eldar6776/WindSwitch/doc/tabela vjetra.pdf

DIP
vrijednost
Frekvencija (Hz) Brzina vjetra (m/s) | Opis snage vjetra | Period (ms)
0 | 0.0 Hz | 0.0 m/s | Nema vjetra | ∞ (pauza)
1 | 1.0 Hz | 0.4 m/s | Slabi povjetarac | 1000
2 | 2.0 Hz | 0.8 m/s | Lagani vjetar | 500
3 | 4.0 Hz | 1.6 m/s | Pomjera lišće | 250
4 | 6.5 Hz | 2.6 m/s | Počinje nositi prašinu | 154
5 | 10 Hz | 4.0 m/s | Lagani povjetarac | 100
6 | 15 Hz | 6.0 m/s | Počinje biti neugodno | 67
7 | 20 Hz | 8.0 m/s | Jak vjetar | 50
8 | 25 Hz | 10.0 m/s | Obara veš sa štrikova | 40
9 | 30 Hz | 12.0 m/s | Ljuljaju se krošnje | 33
10 | 35 Hz | 14.0 m/s | Hodanje postaje teško | 29
11 | 40 Hz | 16.0 m/s | Počinje obarati grane | 25
12 | 45 Hz | 18.0 m/s | Nositi šešir postaje nemoguće | 22
13 | 50 Hz | 20.0 m/s | Vrlo jak vjetar | 20
14 | 60 Hz | 24.0 m/s | Snažan vjetar, ruši manje stvari | 17
15 | 75 Hz | 30.0 m/s | Čupa grane | 13
16 | 90 Hz | 36.0 m/s | Ruši manje konstrukcije | 11
17–63 | 100 Hz | 40.0 m/s | Skida krovove, ozbiljna šteta | 10
