eldar6776/WindSwitch/hw/DE-230724/DE-230724.pdf

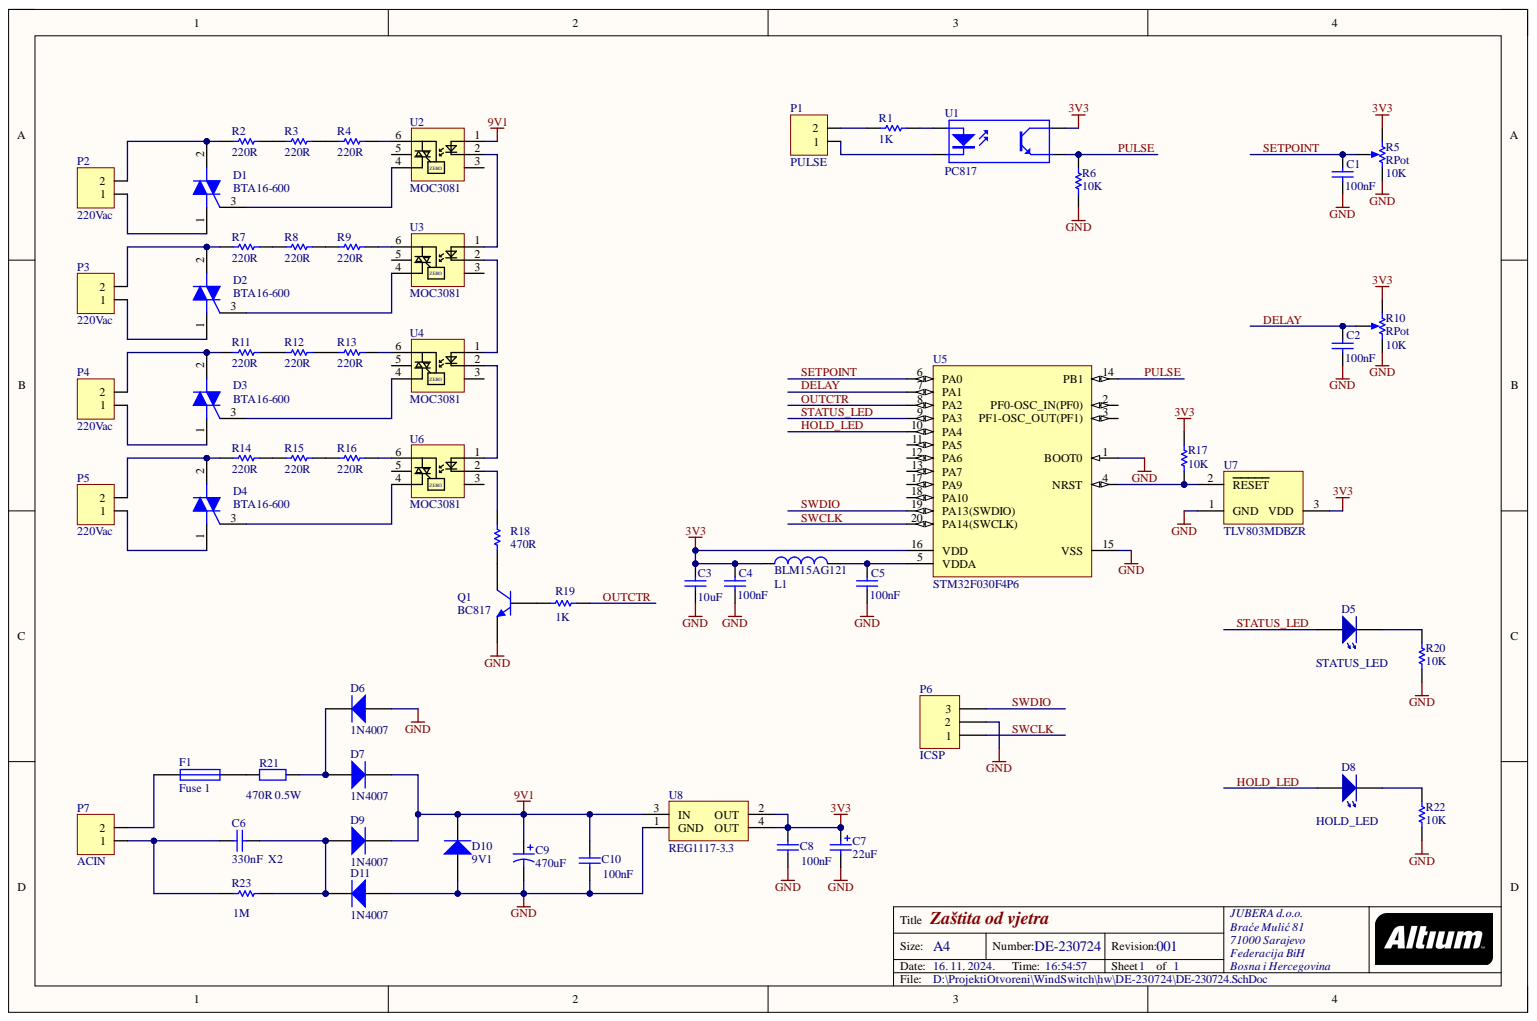
[picture p2: page 1]

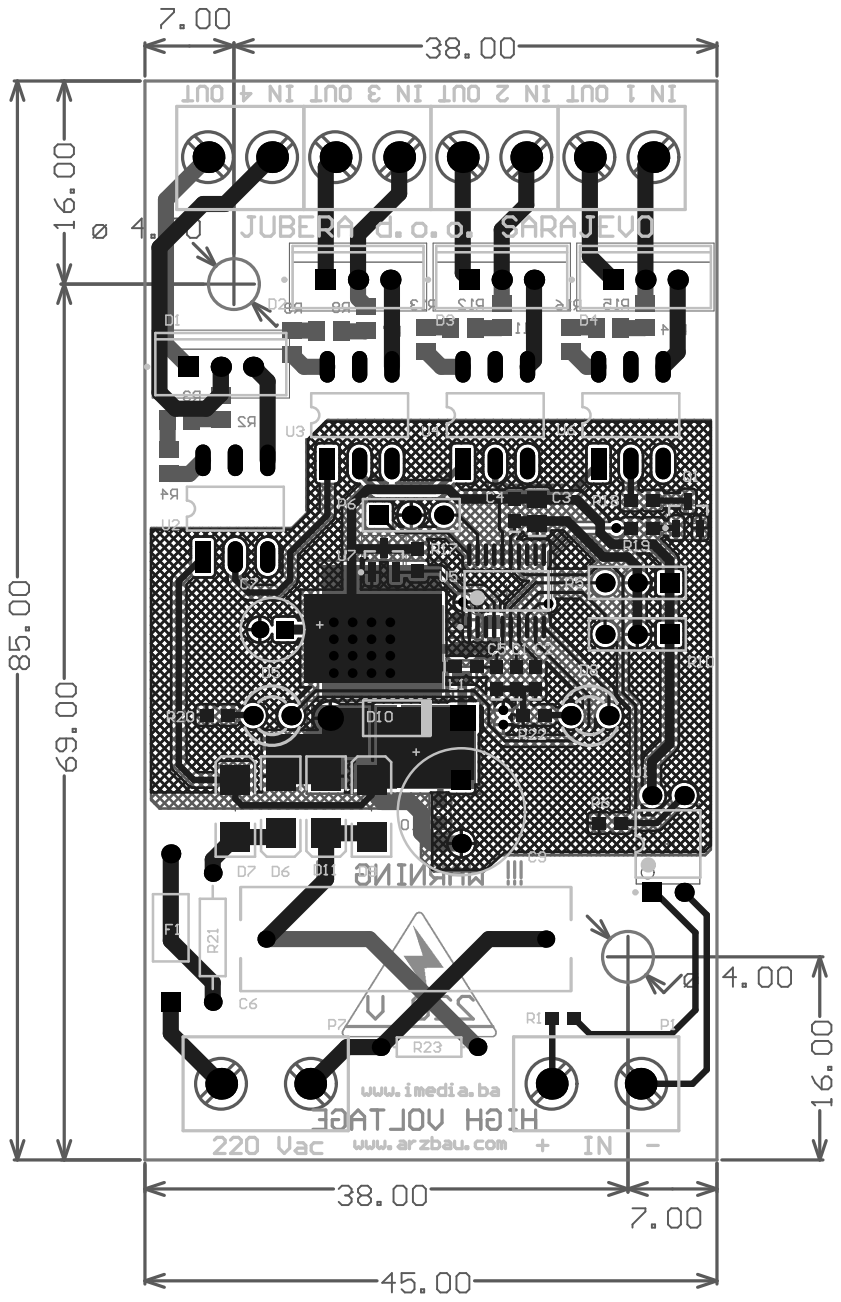
[picture p3: page 2]

Bill of Materials | Bill of Materials for Project [DE-230724.PrjPcb] (No PCB Document Selected)
Source Data From: | DE-230724.PrjPcb
Project: | | DE-230724.PrjPcb
Variant: | | None
Creation Date: 16. 11. 2024. | 16:55
Print Date: | 45612 | 45612,70529
Footprint | Comment | LibRef | Designator | Description | Quantity
603 | C0603 | C0603 | C1, C2, C4, C5, C8, C10 | Ceramic Chip Capacitor - 25V, Ceramic Chip | 6
805 | C0805 | C0805 | C3 | Ceramic Chip Capacitor - 25V | 1
0,33uF X2 | 330nF X2 | 0,33uF X2 | C6 | Dipped Radial Multilayer Ceramic Capacitor | 1
CAPPR2-5X1122uF | EKA00AA247F00C7 | Aluminum Electrolytic Capacitor, Radial Sty | 1
CAPPR5-10X1470uF | EKA00DC347E00C9 | Aluminum Electrolytic Capacitor, Radial Sty | 1
ONSC-TO-220BTA16-600 | BTA08-600BW3GD1, D2, D3, D4 | Triacs, Silicon Bidirectional Thyristor, 3-Pin | 4
LED 3mm | STATUS_LED | LED 3mm | D5 | 1
SMB | 1N4007 | Diode 1N4007 | D6, D7, D9, D11 | 1 Amp General Purpose Rectifier | 4
LED 3mm | HOLD_LED | LED 3mm | D8 | 1
DO-41 | 9V1 | Diode 1N914 | D10 | High Conductance Fast Diode | 1
PIN-W2/E2.8 | Fuse 1 | Fuse 1 | F1 | Fuse | 1
603 | BLM15AG121 | Inductor_SMD | L1 | Inductor | 1
TERMINAL BLPULSE | TERMINAL BLOKP1 | Terminal blok konektor 3,5 mm | 1
TERMINAL BL220Vac | TERMINAL BLOKP2, P3, P4, P5 | Terminal blok konektor 3,5 mm | 4
HDR1X3 | ICSP | Header 3 | P6 | Header, 3-Pin | 1
TERMINAL BLACIN | TERMINAL BLOKP7 | Terminal blok konektor 3,5 mm | 1
SOT23_N | BC817 | BC817 | Q1 | NPN General-purpose Transistor | 1
ERA-0603 | 1K | ERAV | R1, R19 | Metal Film Thermosensitive Chip Resistor, 0 | 2
ERA-0805 | 220R | ERAS | R2, R3, R4, R7, R8, R9, R11, R12, R13,
Metal Film Thermosensitive Chip Resistor, 0 | 12
HDR1X3 | RPot | RPot | R5, R10 | Potentiometer | 2
ERA-0603 | 10K | ERAV | R6, R17, R20, R22 | Metal Film Thermosensitive Chip Resistor, 0 | 4
ERA-0603 | 470R | ERAV | R18 | Metal Film Thermosensitive Chip Resistor, 0 | 1
AXIAL-0.4 | Res2 | Res2 | R21 | Resistor | 1
AXIAL-0.3 | Res1 | Res1 | R23 | Resistor | 1
DIP-4 | PC817 | PC817 | U1 | 4-Pin Phototransistor Optocoupler | 1
DIP6 | MOC3081 | MOC3081 | U2, U3, U4, U6 | Zero-Cross Optoisolator Triac Driver | 4
STM-TSSOP2STM32F030F4P6STM32F030F4P6U5 | ARM Cortex-M0 32-bit MCU, 16 KB Flash, 4 | 1
DBZ3_N | TLV803MDBZR | TLV803MDBZR | U7 | Voltage Supervisor with Active-Low, Open D | 1
ZZ311 | REG1117-3.3 | REG1117-3.3 | U8 | 800mA and 1A Low Dropout Positive Regula | 1

62
Approved | Notes
