eldar6776/WindSwitch/doc/impulsgeber.pdf

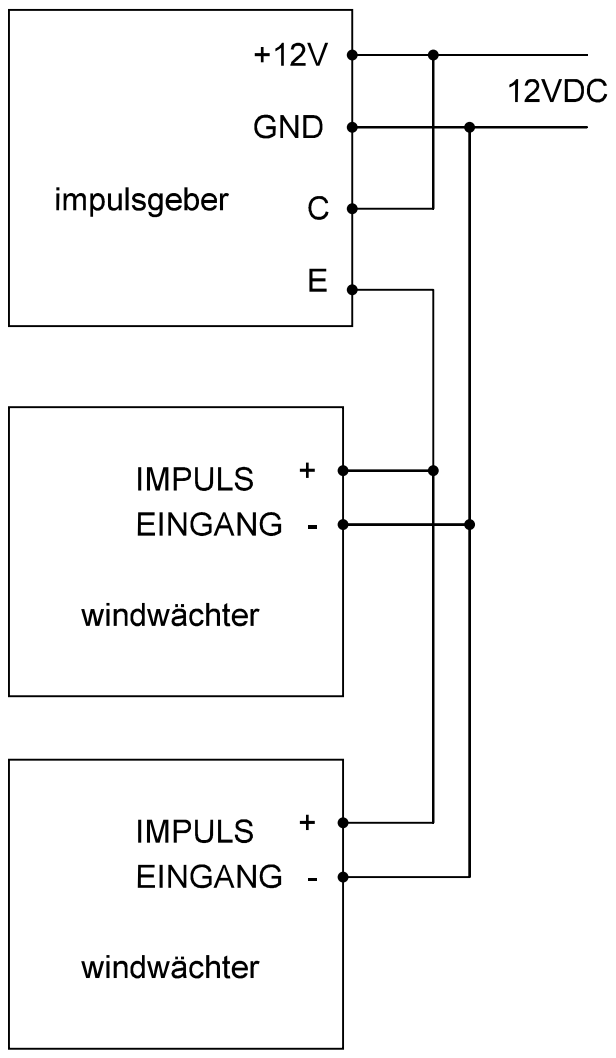
[picture p4: page 1]
