eldar6776/WindSwitch/doc/WindSwitch.pdf

BRZINA | VRIJEME
VJETRA | ODGODE

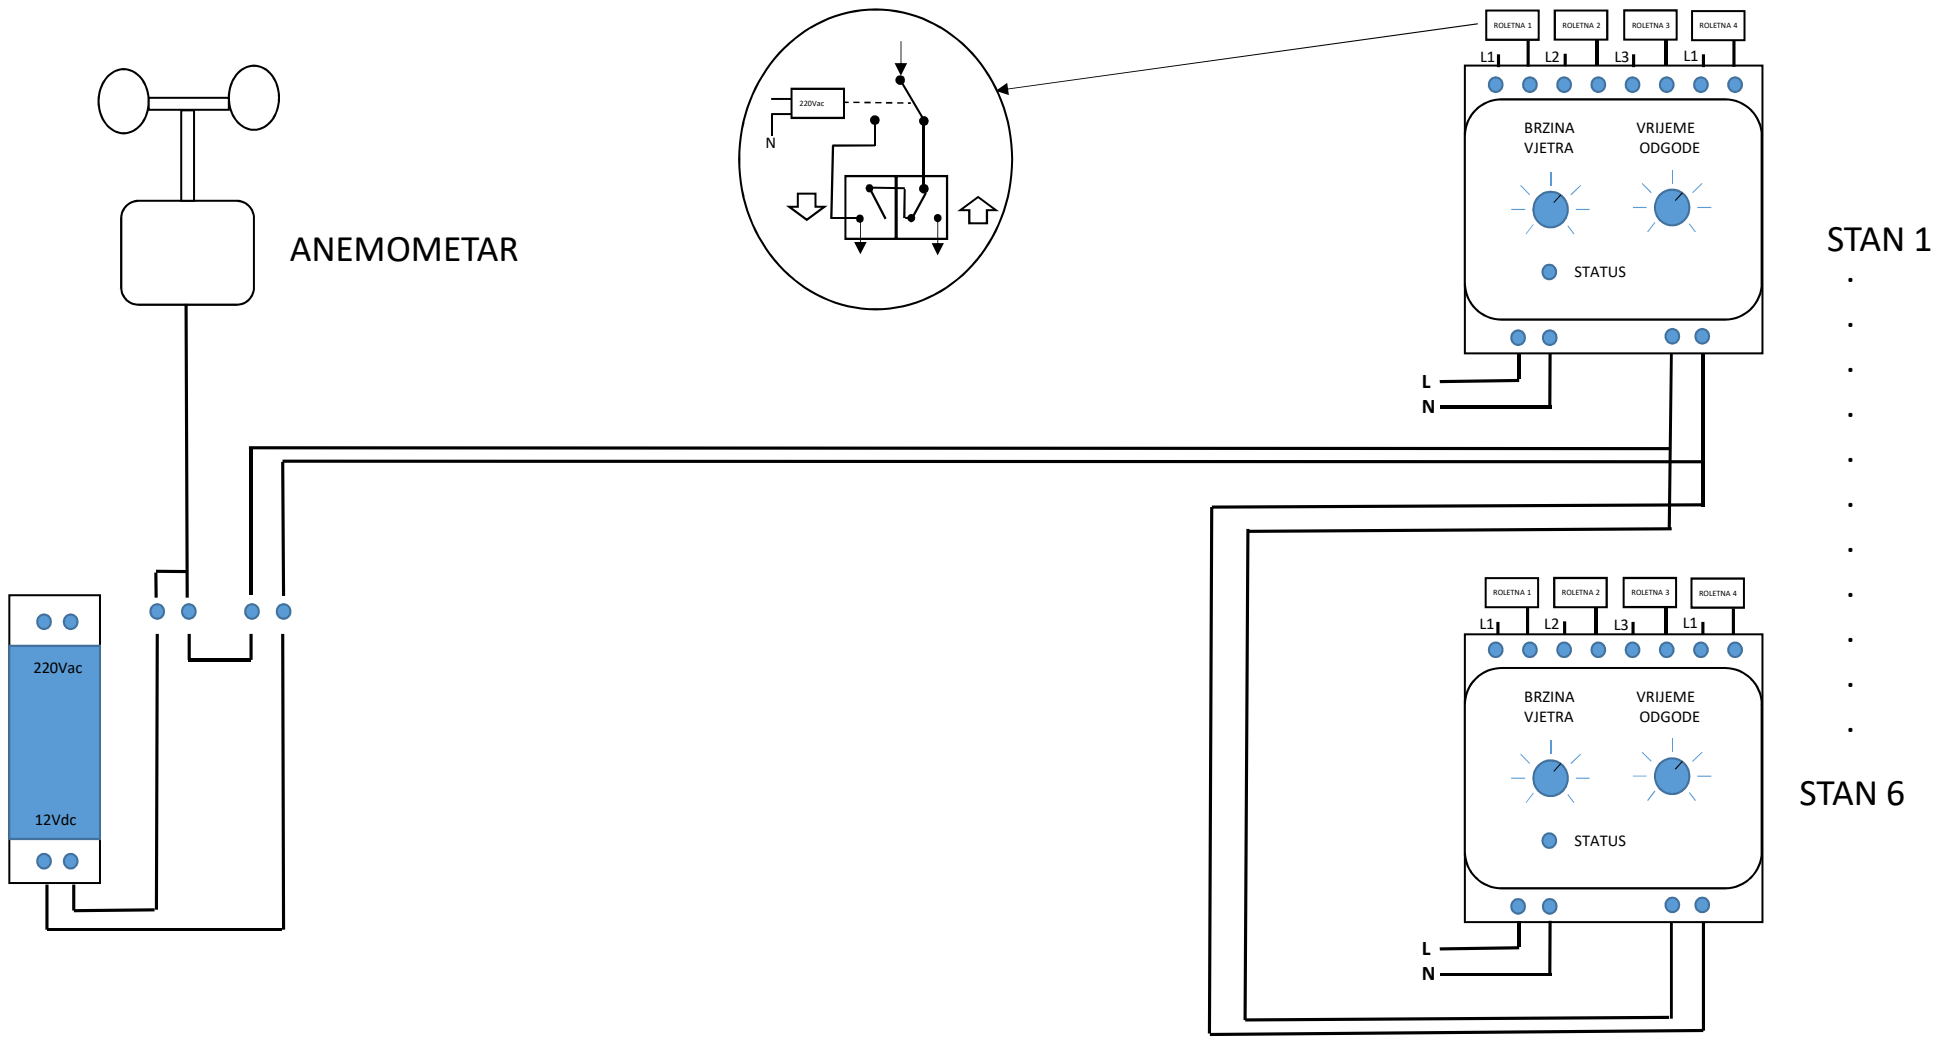
[picture p5: page 1]
BRZINA; VRIJEME; VJETRA; ODGODE; STATUS; 220Vac; 12Vdc; STAN 6; ANEMOMETAR; STAN 1; 220Vac N; ROLETNA 1; ROLETNA 2; ROLETNA 3; ROLETNA 4 L1
