eldar6776/WindSwitch/(list of files, drawings)

Other design files:
hw/DE-230724/DE-230724.PcbDoc
hw/DE-230724/DE-230724.PcbLib
hw/DE-230724/DE-230724.PrjPcb
hw/DE-230724/DE-230724.SchDoc
hw/DE-230724/DE-230724.SchLib
