eldar6776/WindSwitch/fw/DE-070924/Core/Src/main.c

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
/* Includes ------------------------------------------------------------------*/
#include "main.h"

ADC_HandleTypeDef hadc;

IWDG_HandleTypeDef hiwdg;

TIM_HandleTypeDef htim3;

/* USER CODE BEGIN PV */
#define IDLE   0
#define DONE   1
#define F_CLK  8000000UL
#define ADC_READOUT_PERIOD 100
#define TRIGGER_TIME 5000 //  wind treshold to trigger shutter down

volatile uint8_t gu8_State = IDLE, tick = 0, tickcnt = 0, redled = 0, init = 0;
volatile uint8_t gu8_MSG[35] = {'\0'};
volatile uint32_t gu32_T1 = 0;
volatile uint32_t gu32_T2 = 0;
volatile uint32_t gu32_Ticks = 0;
volatile uint16_t gu16_TIM3_OVC = 0;
volatile uint32_t gu32_Freq = 0;
volatile uint32_t ledtmr, ledtime = 200, nulltmr = 0, trgtmr = 0;
volatile uint32_t redledtmr = 0;
volatile uint8_t setpoint = 0, delay = 0;
/* USER CODE END PV */

void SystemClock_Config(void);
static void MX_GPIO_Init(void);
static void MX_ADC_Init(void);
static void MX_IWDG_Init(void);
static void MX_TIM3_Init(void);
/* USER CODE BEGIN PFP */
static void LED(void);
static void OUT(void);
static void ADC3_Read(void);
long map(long x, long in_min, long in_max, long out_min, long out_max);
/* USER CODE END PFP */

/**
  * @brief  The application entry point.
  * @retval int
  */
int main(void)
{

	/* MCU Configuration--------------------------------------------------------*/

	/* Reset of all peripherals, Initializes the Flash interface and the Systick. */
	HAL_Init();

	/* Configure the system clock */
	SystemClock_Config();

	/* Initialize all configured peripherals */
	MX_GPIO_Init();
	MX_ADC_Init();
	MX_IWDG_Init();
	MX_TIM3_Init();

	/* USER CODE BEGIN 2 */
	HAL_TIM_Base_Start_IT(&htim3);
	HAL_TIM_IC_Start_IT(&htim3, TIM_CHANNEL_4);

	/* USER CODE END 2 */

	/* Infinite loop */
	/* USER CODE BEGIN WHILE */
	while(1)
	{
		ADC3_Read();
		LED();
		OUT();
		/* USER CODE END WHILE */

		/* USER CODE BEGIN 3 */
		if(nulltmr && (HAL_GetTick() - nulltmr >= 2000))
		{
			gu32_Freq = 0;
			nulltmr = 0;
		}

#ifdef USE_WATCHDOG
		HAL_IWDG_Refresh(&hiwdg);
#endif
	}
	/* USER CODE END 3 */
}

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
/* USER CODE BEGIN 4 */
long map(long x, long in_min, long in_max, long out_min, long out_max)
{
	return (x - in_min) * (out_max - out_min) / (in_max - in_min) + out_min;
}

void HAL_TIM_IC_CaptureCallback(TIM_HandleTypeDef* htim)
{
	if(gu8_State == IDLE)
	{
		gu32_T1 = TIM3->CCR4;
		gu16_TIM3_OVC = 0;
		gu8_State = DONE;
	}
	else if(gu8_State == DONE)
	{
		gu32_T2 = TIM3->CCR4;
		gu32_Ticks = (gu32_T2 + (gu16_TIM3_OVC * 65536)) - gu32_T1;
		gu32_Freq = (uint32_t)(F_CLK / gu32_Ticks) + 1;
		gu8_State = IDLE;
		tick = 1;
	}
	nulltmr = HAL_GetTick();
}

void HAL_TIM_PeriodElapsedCallback(TIM_HandleTypeDef* htim)
{
	gu16_TIM3_OVC++;
}

static void OUT(void)
{
	if(!init) return;

	switch(redled)
	{
		case 0:
			if(setpoint < gu32_Freq)
			{
				trgtmr = HAL_GetTick();
				++redled;
			}
			break;
		case 1:
			if(setpoint >= gu32_Freq)
			{
				redled = 0;
			}
			else if((HAL_GetTick() - trgtmr) >= TRIGGER_TIME)
			{
				HAL_GPIO_WritePin(OUTCTRL_GPIO_Port, OUTCTRL_Pin, GPIO_PIN_SET);
				trgtmr = HAL_GetTick();
				++redled;
			}
			break;
		case 2:
			if(setpoint < gu32_Freq)
			{
				trgtmr = HAL_GetTick();
			}
			else if((HAL_GetTick() - trgtmr) >= (delay * 60000U))
			{
				HAL_GPIO_WritePin(OUTCTRL_GPIO_Port, OUTCTRL_Pin, GPIO_PIN_RESET);
				trgtmr = 0;
				redled = 0;
				redledtmr = 0;
			}
			break;
		default:
			trgtmr = 0;
			redled = 0;
			redledtmr = 0;
			break;

	}
}

static void LED(void)
{
	if(tick)
	{
		if(tickcnt == 0)
		{
			HAL_GPIO_WritePin(STATUS_LED_GPIO_Port, STATUS_LED_Pin, GPIO_PIN_SET);
			ledtmr = HAL_GetTick();
			++tickcnt;
		}
		else if(tickcnt == 1)
		{
			if((HAL_GetTick() - ledtmr) >= 5)
			{
				tick = 0;
				tickcnt = 0;
				ledtmr = HAL_GetTick();
				HAL_GPIO_WritePin(STATUS_LED_GPIO_Port, STATUS_LED_Pin, GPIO_PIN_RESET);
			}
		}
	}
	else if((HAL_GetTick() - ledtmr) >= ledtime)
	{
		ledtmr = HAL_GetTick();
		if(HAL_GPIO_ReadPin(STATUS_LED_GPIO_Port, STATUS_LED_Pin) == GPIO_PIN_SET)
		{
			HAL_GPIO_WritePin(STATUS_LED_GPIO_Port, STATUS_LED_Pin, GPIO_PIN_RESET);
			ledtime = 5000;
		}
		else
		{
			HAL_GPIO_WritePin(STATUS_LED_GPIO_Port, STATUS_LED_Pin, GPIO_PIN_SET);
			ledtime = 5;
		}
	}

	if(redled == 0)
	{
		HAL_GPIO_WritePin(HOLD_LED_GPIO_Port, HOLD_LED_Pin, GPIO_PIN_RESET);
	}
	else if(redled == 1)
	{
		if((HAL_GetTick() - redledtmr) >= 100)
		{
			redledtmr = HAL_GetTick();
			HAL_GPIO_TogglePin(HOLD_LED_GPIO_Port, HOLD_LED_Pin);
		}
	}
	else if(redled == 2) HAL_GPIO_WritePin(HOLD_LED_GPIO_Port, HOLD_LED_Pin, GPIO_PIN_SET);

}
/**
  * @brief
  * @param
  * @retval
  */
static void ADC3_Read(void)
{
	ADC_ChannelConfTypeDef sConfig;

	static uint32_t adc_timer = 0U;
	static uint32_t setpoint_sample_cnt = 0U;
	static uint32_t delay_sample_cnt = 0U;
	static uint16_t setpoint_sample[10] = {0U, 0U, 0U, 0U, 0U, 0U, 0U, 0U, 0U, 0U};
	static uint16_t delay_sample[10] = {0U, 0U, 0U, 0U, 0U, 0U, 0U, 0U, 0U, 0U};
	static uint8_t adc_cnt = 0U;
	uint32_t tmp_val = 0, t = 0;


	if((HAL_GetTick() - adc_timer) >= ADC_READOUT_PERIOD)
	{
		adc_timer = HAL_GetTick();
		sConfig.Rank = ADC_RANK_CHANNEL_NUMBER;
		sConfig.SamplingTime = ADC_SAMPLETIME_13CYCLES_5;
		if(adc_cnt == 0U) sConfig.Channel = ADC_CHANNEL_0;
		else if(adc_cnt == 1U) sConfig.Channel = ADC_CHANNEL_1;
		HAL_ADC_ConfigChannel(&hadc, &sConfig);
		HAL_ADC_Start(&hadc);
		HAL_ADC_PollForConversion(&hadc, 10);

		if(adc_cnt == 0U)
		{
			setpoint_sample[setpoint_sample_cnt] = HAL_ADC_GetValue(&hadc);
			if(++setpoint_sample_cnt >  9U) setpoint_sample_cnt = 0U;
			tmp_val = 0U;
			for(t = 0U; t < 10U; t++) tmp_val += setpoint_sample[t];
			tmp_val = tmp_val / 10U;
			setpoint = map(tmp_val, 0, 4095, 0, 100);
			++adc_cnt;
		}
		else if(adc_cnt == 1U)
		{
			delay_sample[delay_sample_cnt] = HAL_ADC_GetValue(&hadc);
			if(++delay_sample_cnt >  9U)
			{
				delay_sample_cnt = 0U;
				init = 1;
			}
			tmp_val = 0U;
			for(t = 0U; t < 10U; t++) tmp_val += delay_sample[t];
			tmp_val = tmp_val / 10U;
			delay = map(tmp_val, 0, 4095, 0, 50);
			adc_cnt = 0;
		}
	}
}
/* USER CODE END 4 */
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
