eldar6776/WindSwitch/fw/ImpulsGeber/Core/Inc/main.h

#define LED_RED_Pin GPIO_PIN_0
#define LED_RED_GPIO_Port GPIOB
#define LED_GREEN_Pin GPIO_PIN_1
#define LED_GREEN_GPIO_Port GPIOB
#define BUZZER_Pin GPIO_PIN_2
#define BUZZER_GPIO_Port GPIOB
#define ADDRESS_1_Pin GPIO_PIN_10
#define ADDRESS_1_GPIO_Port GPIOB
#define ADDRESS_2_Pin GPIO_PIN_11
#define ADDRESS_2_GPIO_Port GPIOB
#define ADDRESS_4_Pin GPIO_PIN_12
#define ADDRESS_4_GPIO_Port GPIOB
#define ADDRESS_8_Pin GPIO_PIN_13
#define ADDRESS_8_GPIO_Port GPIOB
#define ADDRESS_16_Pin GPIO_PIN_14
#define ADDRESS_16_GPIO_Port GPIOB
#define ADDRESS_32_Pin GPIO_PIN_15
#define ADDRESS_32_GPIO_Port GPIOB
#define DOOR_LOCK_Pin GPIO_PIN_3
#define DOOR_LOCK_GPIO_Port GPIOB
#define LED_STATUS_Pin GPIO_PIN_4
#define LED_STATUS_GPIO_Port GPIOB
#define WR_ENABLE_Pin GPIO_PIN_5
#define WR_ENABLE_GPIO_Port GPIOB
#define GET_SYS_FLAG        0xA0 // traži flagove sistema
#define GET_CARD_CNT        0xA1 // broj kartica u eepromu
#define GET_CARD_PRESENT    0xA2 // traži karticu u eepromu
#define GET_EVENT_CNT       0xA3 // broj događaja u eepromu
#define GET_EVENT_LAST      0xA4 // traži zadnji događaj iz eeproma
#define SET_SYS_TIME        0xB0 // podesi vrijeme sa param
#define SET_SYS_RESTART     0xB1 // softwerski restart applikacije
#define SET_CARD_ONE        0xB2 // dodaj novu karticu u eeprom
#define SET_DOOR_OPEN       0xB3 // aktiviraj bravu
#define SET_DOOR_TIME       0xB4 // podesi vrijeme brave
#define SET_DOOR_ENABLE     0xB5 // omogući kontrolu brave
#define SET_DOOR_DISABLE    0xB6 // onemogući kontrolu brave
#define SET_BUZZER_ENABLE   0xB7 // omogući buzzer
#define SET_BUZZER_DISABLE  0xB8 // onemogući buzzer
#define DELETE_CARD_ONE     0xC0 // obrisi karticu iz eeproma
#define DELETE_CARD_ALL     0xC1 // obrisi sve kartice iz eeproma
#define DELETE_EVENT_LAST   0xC2 // obrisi događaj prema datom indexu iz eeproma
#define DELETE_EVENT_ALL    0xC3 // obrisi sve događaje iz eeproma
