eldar6776/WindSwitch/fw/ImpulsGeber/Core/Src/main.c

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
/* Includes ------------------------------------------------------------------*/
#include "main.h"

/* USER CODE BEGIN Includes */
#include <stdlib.h>
/* USER CODE END Includes */

/* USER CODE BEGIN PTD */
typedef enum
{
    BUZZ_OFF = 0,
    BUZZ_CARD_VALID,
    BUZZ_CARD_INVALID,
    BUZZ_ERROR
} buzz_tdf;

typedef enum
{
    LED_OFF = 0,
    LED_CARD_VALID,
    LED_CARD_INVALID,
    LED_CARD_BLOCKED,
    LED_ERROR
} led_tdf;

typedef enum
{
    SYS_OK = 0,
    SYS_TXRX,
    SYS_ERR
} status_tdf;

typedef enum
{
    CLOSED = 0,
    OPEN
} doorlock_tdf;

doorlock_tdf door = CLOSED;
status_tdf state = SYS_OK;
led_tdf led = LED_OFF;
buzz_tdf buzz = BUZZ_OFF;
const uint16_t max_card_number = 250;
/* USER CODE END PTD */

I2C_HandleTypeDef hi2c1;

IWDG_HandleTypeDef hiwdg;

RTC_HandleTypeDef hrtc;
CRC_HandleTypeDef hcrc;
UART_HandleTypeDef huart1;
UART_HandleTypeDef huart2;

/* USER CODE BEGIN PV */


uint32_t previousTick = 0;
uint32_t pulseDelay = 100; // Početna vrednost (ms), biće postavljena prema DIP switch-u
const uint32_t dip_to_period[64] = {
    0, 500, 250, 125, 77, 50, 33, 25, 20, 16, 14, 12, 11, 10, 8, 7, 
    6, 5, 5, 5, 5, 5, 5, 5, 5, 5, 5, 5, 5, 5, 5, 5,  
    5, 5, 5, 5, 5, 5, 5, 5, 5, 5, 5, 5, 5, 5, 5, 5,  
    5, 5, 5, 5, 5, 5, 5, 5, 5, 5, 5, 5, 5, 5, 5, 5  
};


/* USER CODE END PV */

void SystemClock_Config(void);
static void MX_GPIO_Init(void);
/* USER CODE BEGIN PFP */
static uint32_t ReadDIP(void);

/* USER CODE END PFP */

/**
  * @brief  The application entry point.
  * @retval int
  */
int main(void)
{
    /* MCU Configuration--------------------------------------------------------*/

    /* Reset of all peripherals, Initializes the Flash interface and the Systick. */
    HAL_Init();

    /* Configure the system clock */
    SystemClock_Config();

    /* Initialize all configured peripherals */
    MX_GPIO_Init();

    /* Infinite loop */
    /* USER CODE BEGIN WHILE */
    while(1)
    {
        // Povremeno ažuriraj vrednost iz DIP switch-a
        static uint32_t lastDipRead = 0;
        if (HAL_GetTick() - lastDipRead >= 500) {  // Čitaj DIP na svakih 500ms
            lastDipRead = HAL_GetTick();
            pulseDelay = ReadDIP();
        }
        if (pulseDelay && (HAL_GetTick() - previousTick >= pulseDelay)) {
            previousTick = HAL_GetTick(); // Ažuriraj referentni trenutak
            HAL_GPIO_TogglePin(DOOR_LOCK_GPIO_Port, DOOR_LOCK_Pin); // Toggle impulsa
            HAL_GPIO_TogglePin(LED_STATUS_GPIO_Port, LED_STATUS_Pin); // Toggle impulsa
        }
        /* USER CODE END WHILE */

        /* USER CODE BEGIN 3 */
    }
    /* USER CODE END 3 */
}

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
/* USER CODE BEGIN 4 */
/**
  * @brief  init app
  * @param  none
  * @retval none
  */
static uint32_t ReadDIP(void)
{
    uint8_t rsadd = 0;
    if(HAL_GPIO_ReadPin(ADDRESS_1_GPIO_Port, ADDRESS_1_Pin) == GPIO_PIN_RESET) rsadd |= 0x01U;
    if(HAL_GPIO_ReadPin(ADDRESS_2_GPIO_Port, ADDRESS_2_Pin) == GPIO_PIN_RESET) rsadd |= 0x02U;
    if(HAL_GPIO_ReadPin(ADDRESS_4_GPIO_Port, ADDRESS_4_Pin) == GPIO_PIN_RESET) rsadd |= 0x04U;
    if(HAL_GPIO_ReadPin(ADDRESS_8_GPIO_Port, ADDRESS_8_Pin) == GPIO_PIN_RESET) rsadd |= 0x08U;
    if(HAL_GPIO_ReadPin(ADDRESS_16_GPIO_Port, ADDRESS_16_Pin) == GPIO_PIN_RESET) rsadd |= 0x10U;
    if(HAL_GPIO_ReadPin(ADDRESS_32_GPIO_Port, ADDRESS_32_Pin) == GPIO_PIN_RESET) rsadd |= 0x20U;
    
    return(dip_to_period[rsadd]);

}
/* USER CODE END 4 */
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
