eldar6776/WindSwitch/(commit log)

2024-07-24 hw pcb sample
    [DE-230724.GBL, DE-230724.GBO, DE-230724.GBP, DE-230724.GBS, DE-230724.GKO, DE-230724.GM1, DE-230724.GTL, DE-230724.GTO]
2025-10-31 Enhance README with comprehensive device information
    Added detailed description, features, specifications, and installation instructions for the WindSwitch device.
2026-05-16 Add assembled device image to README
